mattytrog/ftplus/CPU/firmware/v1.7.0b/Notes.txt

v1.7.0b - Bugfix release
Zero wasn't being hidden when frequency was under 10mhz - FIXED
Frequency was counting up by 2 instead of 1 in fine tune mode with accelerated dial enabled = FIXED
Redone CAT tx as tx inhibit wasn't working correctly via standard PTT - FIXED
Frequency updates via CAT was triggering the fine tune display, regardless of frequency jump, leading to confusion - ALTERATION
Timings sync'd to 50hz for CPU control and 2.5khz for complete VFD refresh, to maintain compatibility across all TMS chip implementations - ALTERATION
Removed CAT command timeout. Was disabled in release versions anyway, but was an option in source. Removed completely now - ALTERATION

v1.7.0 – Mostly CAT changes
    • Cat TX in CLAR or SPLIT modes now works correctly
    • Cat driver improvements – Commander in Yaesu mode works correctly now
    • Y-Library introduction:
        ◦ Complete front panel control with PMS and 500k ‘virtual’ buttons
        ◦ Complete FTPlus command control over CAT
        ◦ Statuses returned on required functions
        ◦ Offset / RIT information is now controllable over CAT

BUGFIX D v1.6.0

Changed beeper pulse for aftermarket dial boards (40uS instead of 20uS)
Tuned display driver interrupts and timings(no visible difference - for compatibility purposes)
Manual button tuning CAT hook has been restored, so CAT changes are reflected in manual button tuning mode
and visa-versa.
