mattytrog/ftplus/DIAL UNIT/GERBERS_16F684/16f684.png

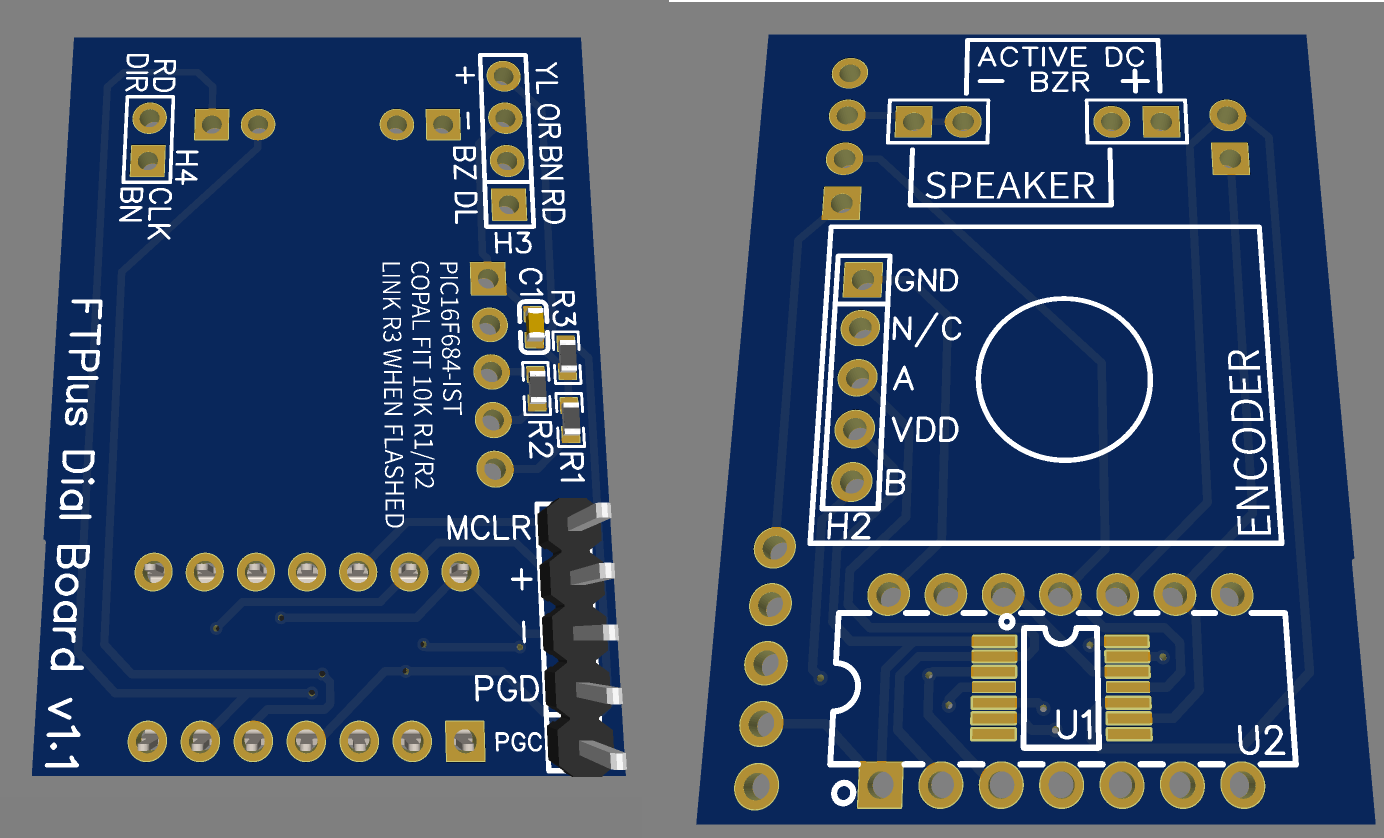
DIAL UNIT/GERBERS_16F684/16f684.png
